DevManyPB/Control-2/presentaciones/pecha_kucha/img/bioreactor.jpg

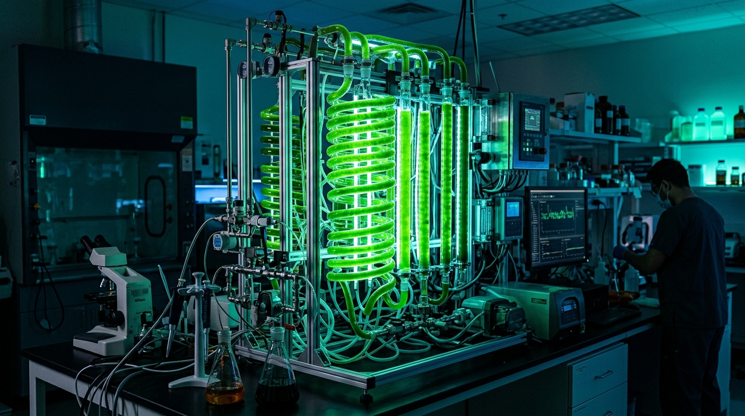
presentaciones/pecha_kucha/img/bioreactor.jpg
