DevManyPB/Control-2/presentaciones/pecha_kucha/img/frailejon.jpg

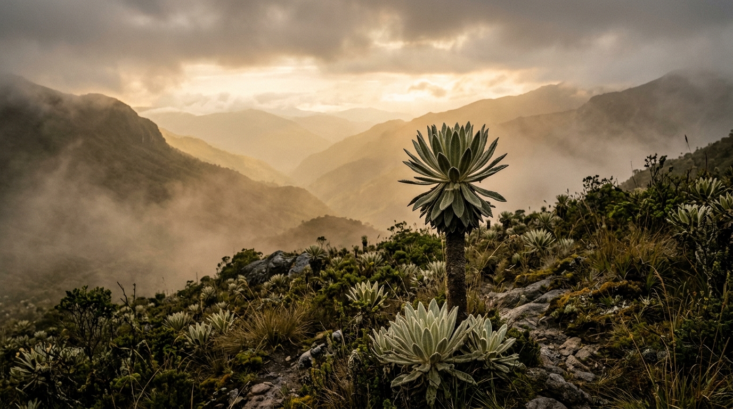
presentaciones/pecha_kucha/img/frailejon.jpg
