DevManyPB/Control-2/presentaciones/pecha_kucha/img/hardware.jpg

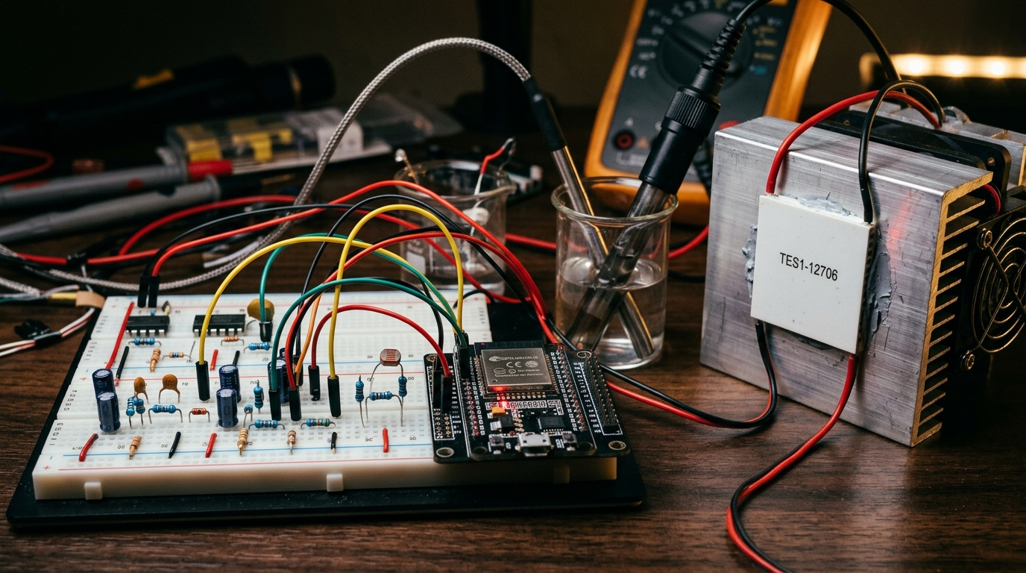
presentaciones/pecha_kucha/img/hardware.jpg
