DevManyPB/Control-2/presentaciones/pecha_kucha/img/microalgae.jpg

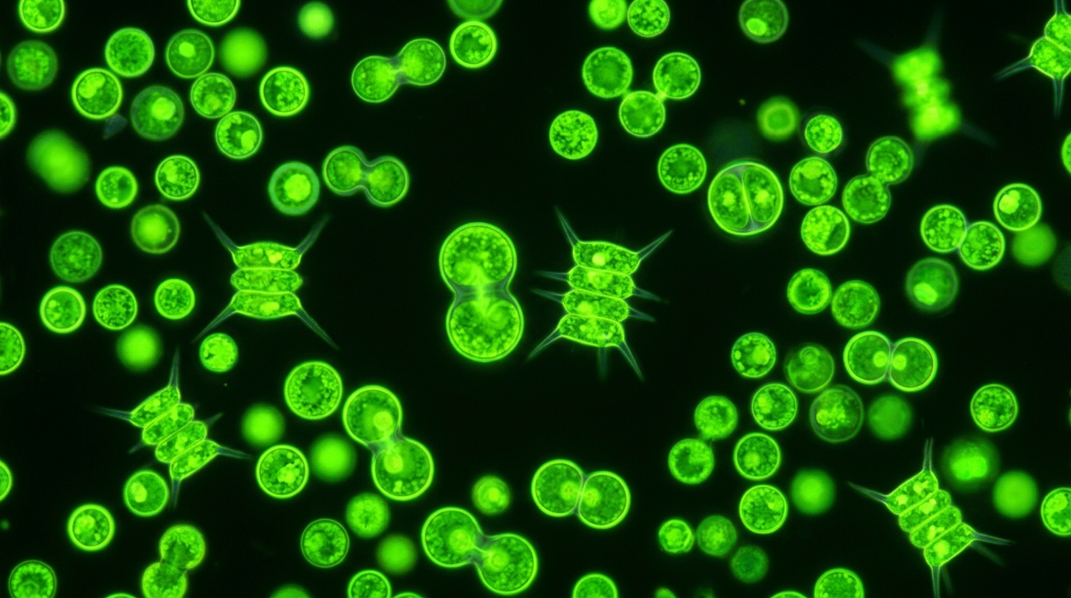
presentaciones/pecha_kucha/img/microalgae.jpg
