DevManyPB/Control-2/presentaciones/pecha_kucha/img/plot_ctmi.png

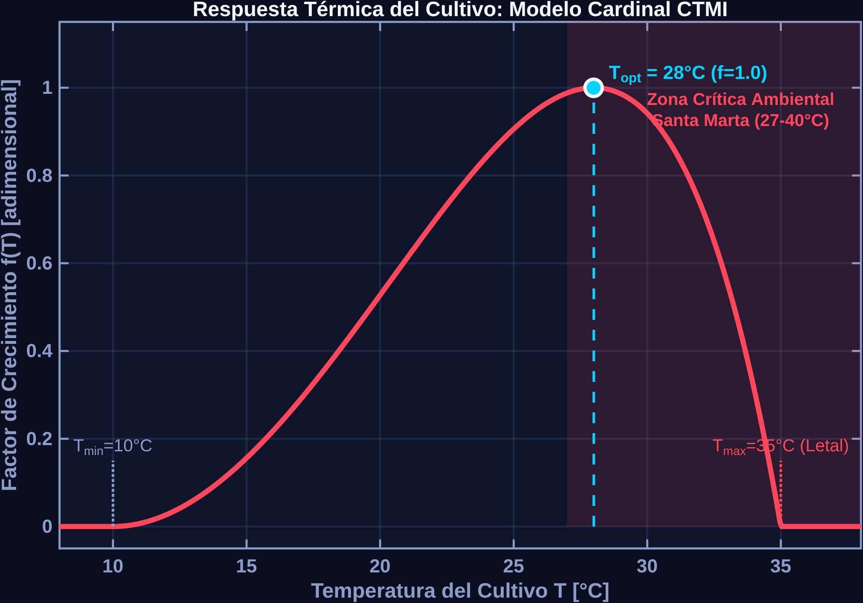
presentaciones/pecha_kucha/img/plot_ctmi.png
