DevManyPB/Control-2/presentaciones/pecha_kucha/img/plot_filter_i.png

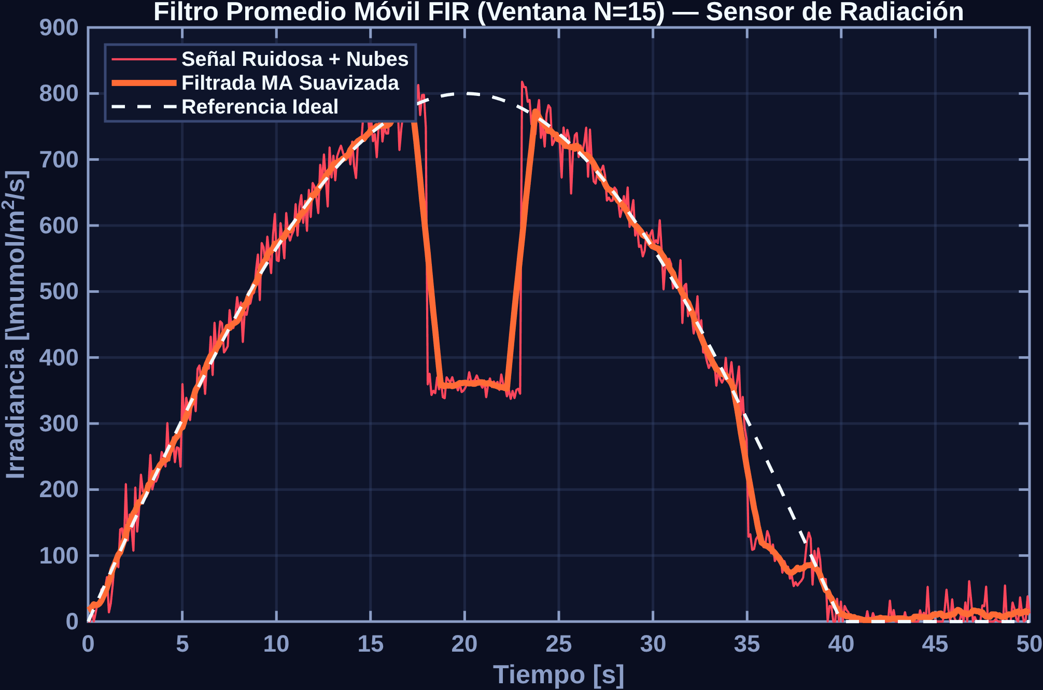
presentaciones/pecha_kucha/img/plot_filter_i.png
