DevManyPB/Control-2/presentaciones/pecha_kucha/img/plot_filter_ph.png

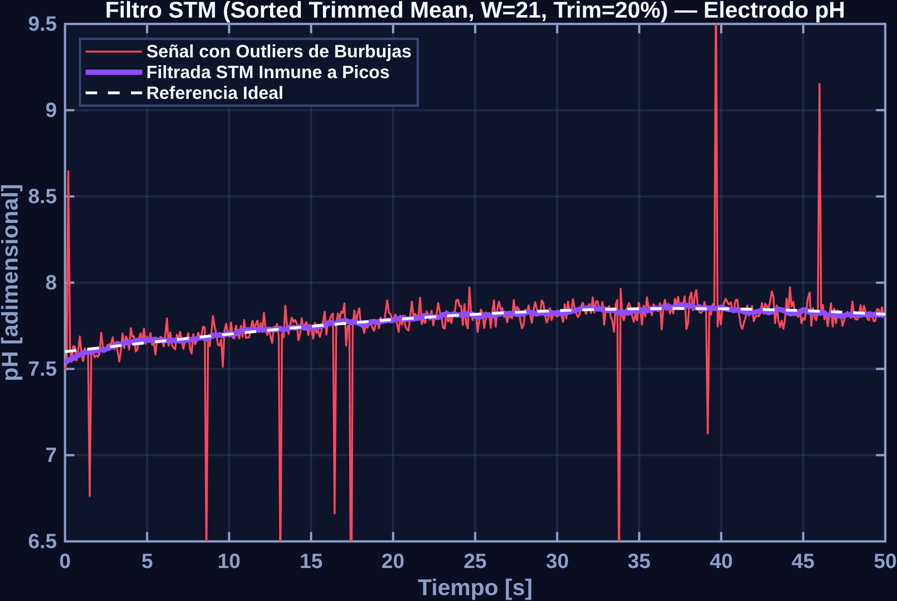
presentaciones/pecha_kucha/img/plot_filter_ph.png
