DevManyPB/Control-2/presentaciones/pecha_kucha/img/plot_filter_t.png

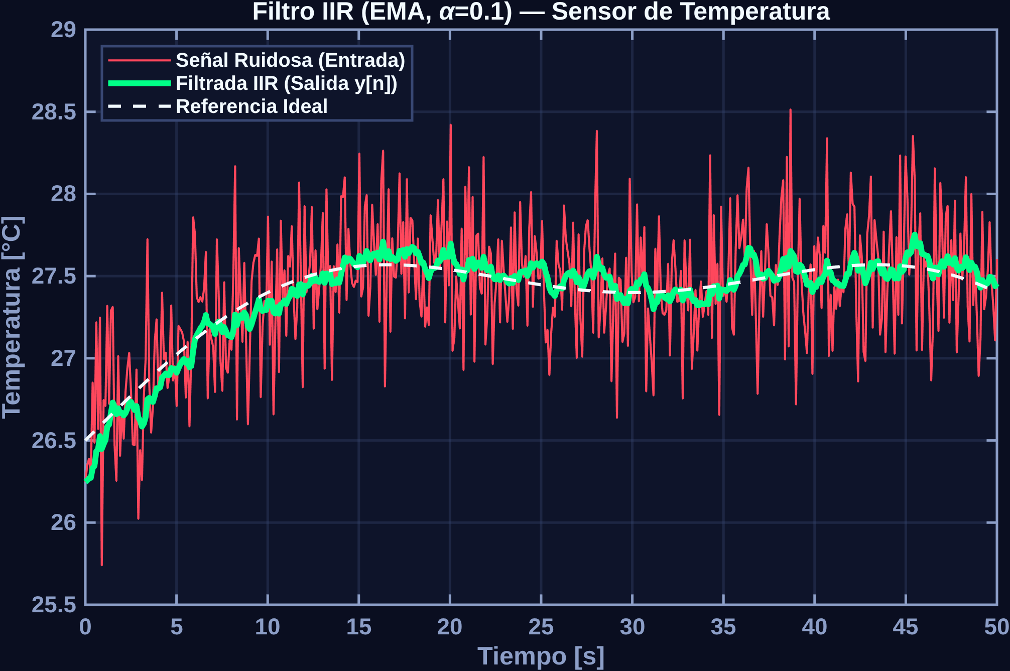
presentaciones/pecha_kucha/img/plot_filter_t.png
