DevManyPB/Control-2/presentaciones/pecha_kucha/img/plot_noise_i.png

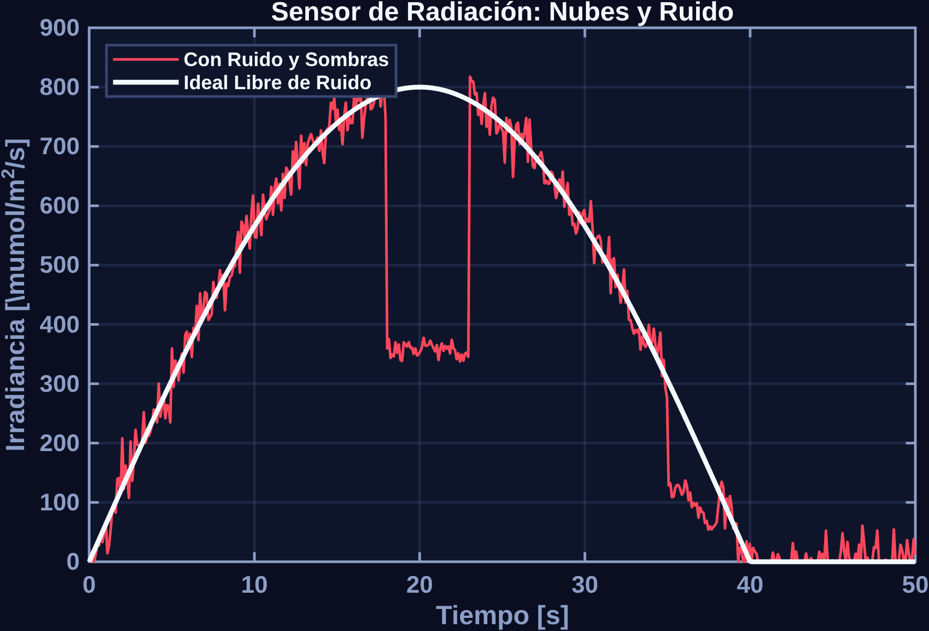
presentaciones/pecha_kucha/img/plot_noise_i.png
