DevManyPB/Control-2/presentaciones/pecha_kucha/img/plot_noise_ph.png

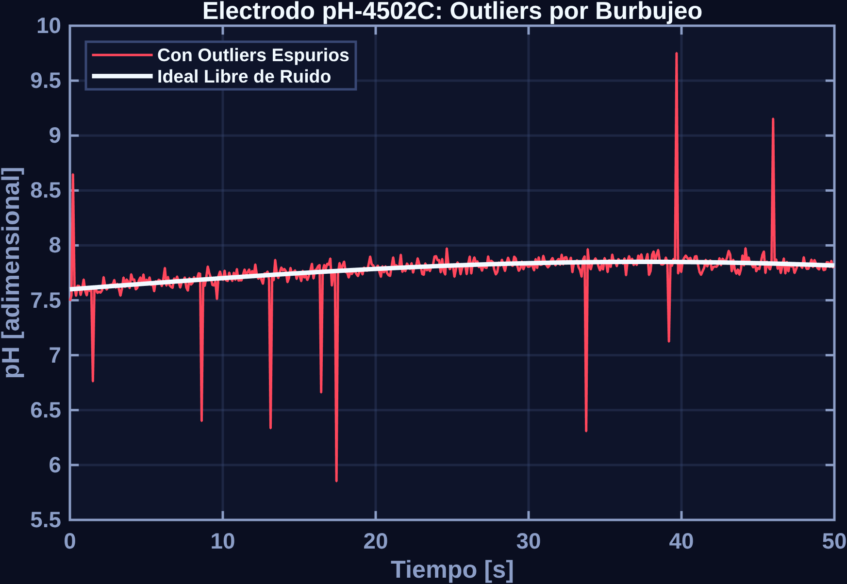
presentaciones/pecha_kucha/img/plot_noise_ph.png
