DevManyPB/Control-2/presentaciones/pecha_kucha/img/plot_sim_biomasa.png

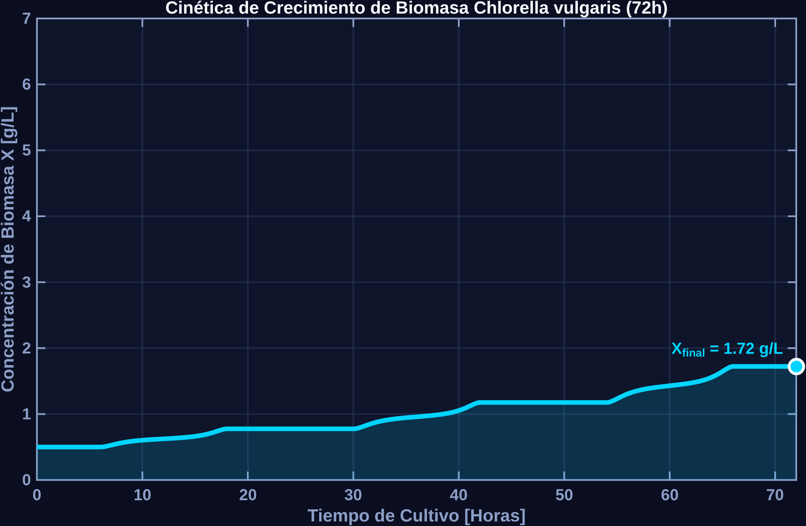
presentaciones/pecha_kucha/img/plot_sim_biomasa.png
