DevManyPB/Control-2/presentaciones/pecha_kucha/img/plot_steele.png

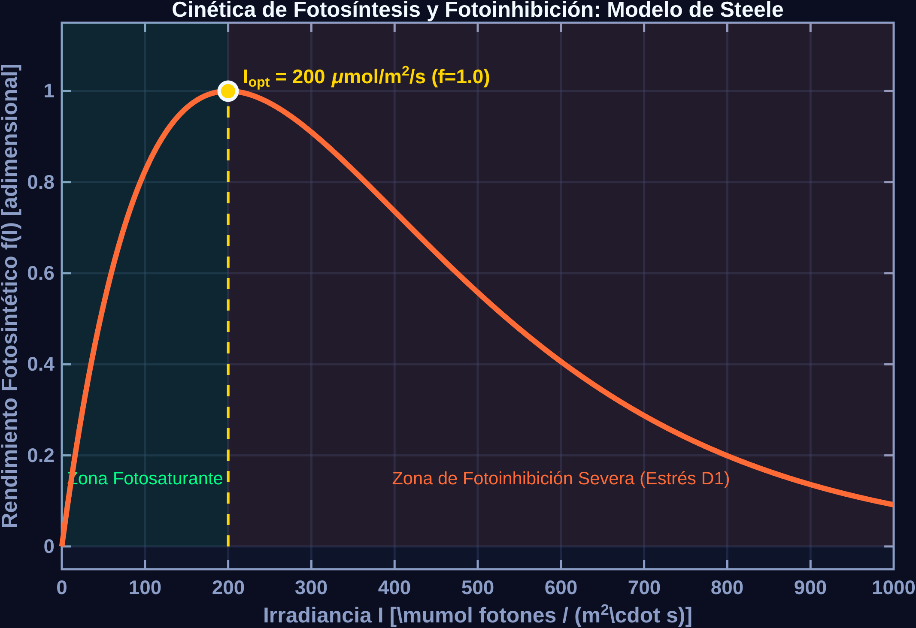
presentaciones/pecha_kucha/img/plot_steele.png
