DevManyPB/Control-2/presentaciones/pecha_kucha/img/signals.jpg

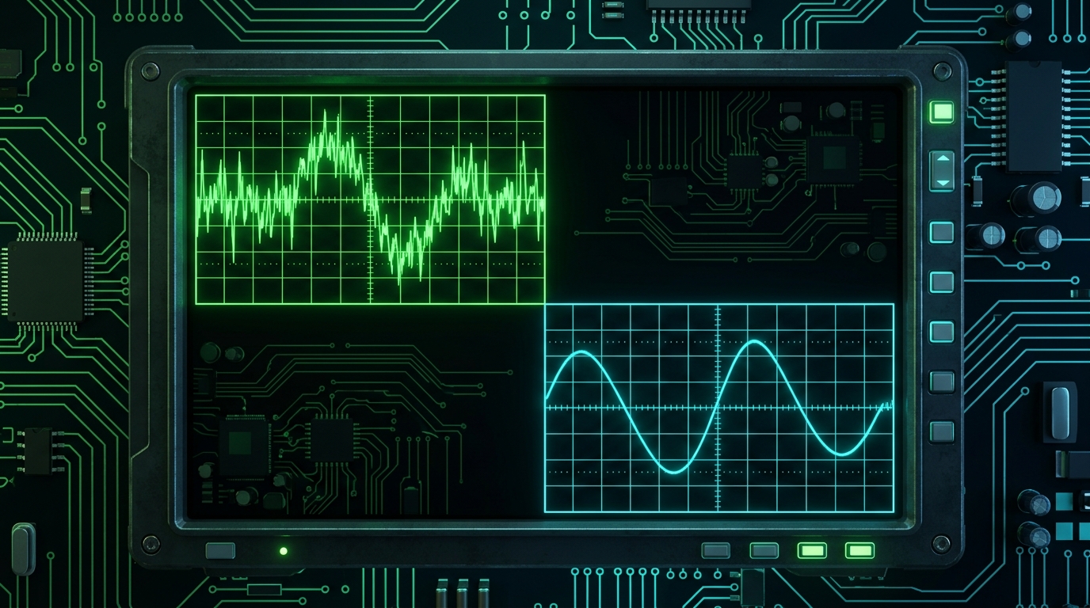
presentaciones/pecha_kucha/img/signals.jpg
