DevManyPB/Control-2/presentaciones/pecha_kucha/img/thermal.jpg

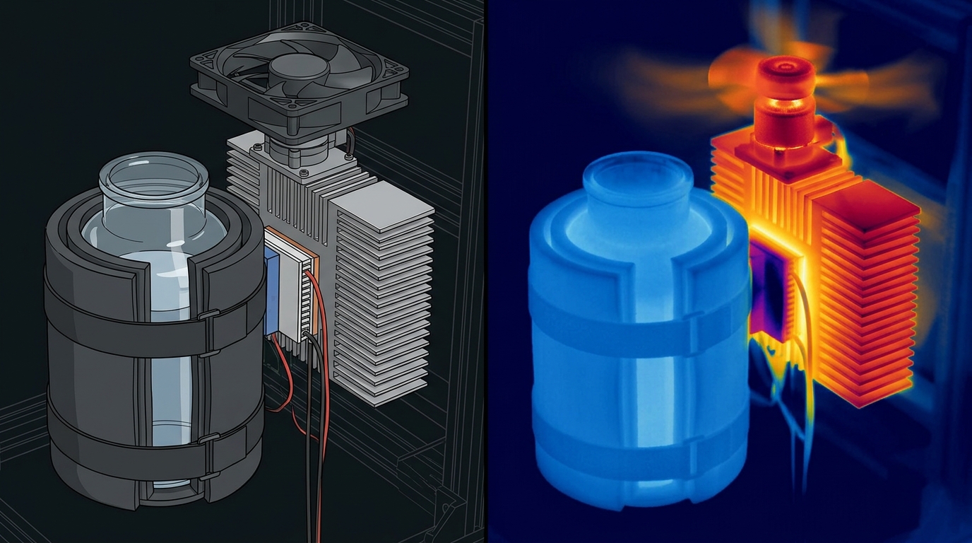
presentaciones/pecha_kucha/img/thermal.jpg
