DevManyPB/Control-2/presentaciones/presentacion_aluna/bioreactor_cartoon_1786323446804.png

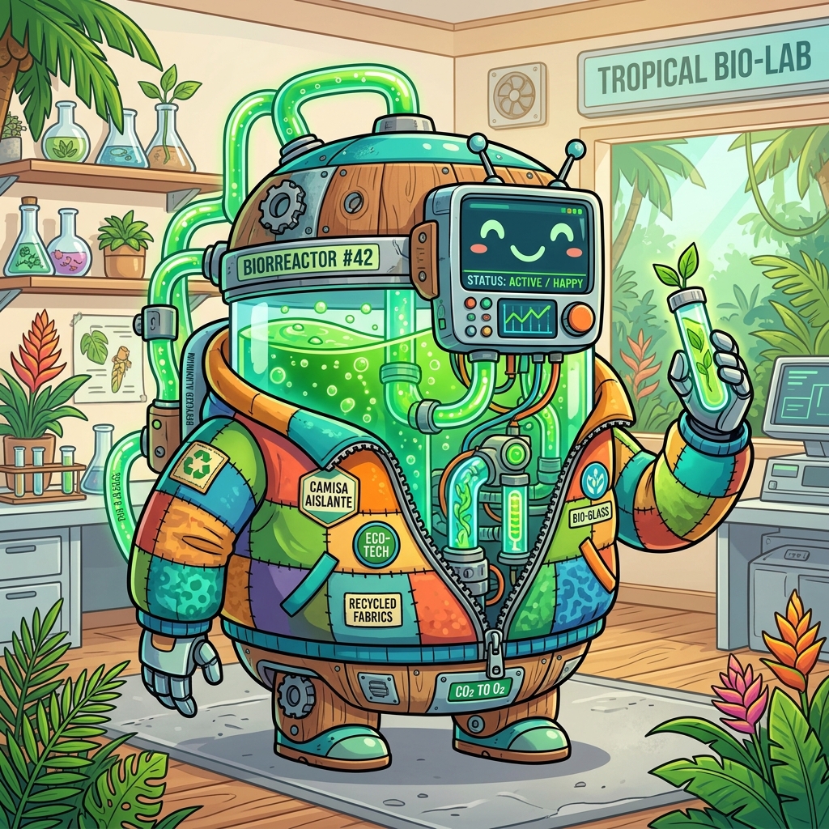
presentaciones/presentacion_aluna/bioreactor_cartoon_1786323446804.png
