DevManyPB/Control-2/presentaciones/presentacion_aluna/chlorella_character_1786323439290.png

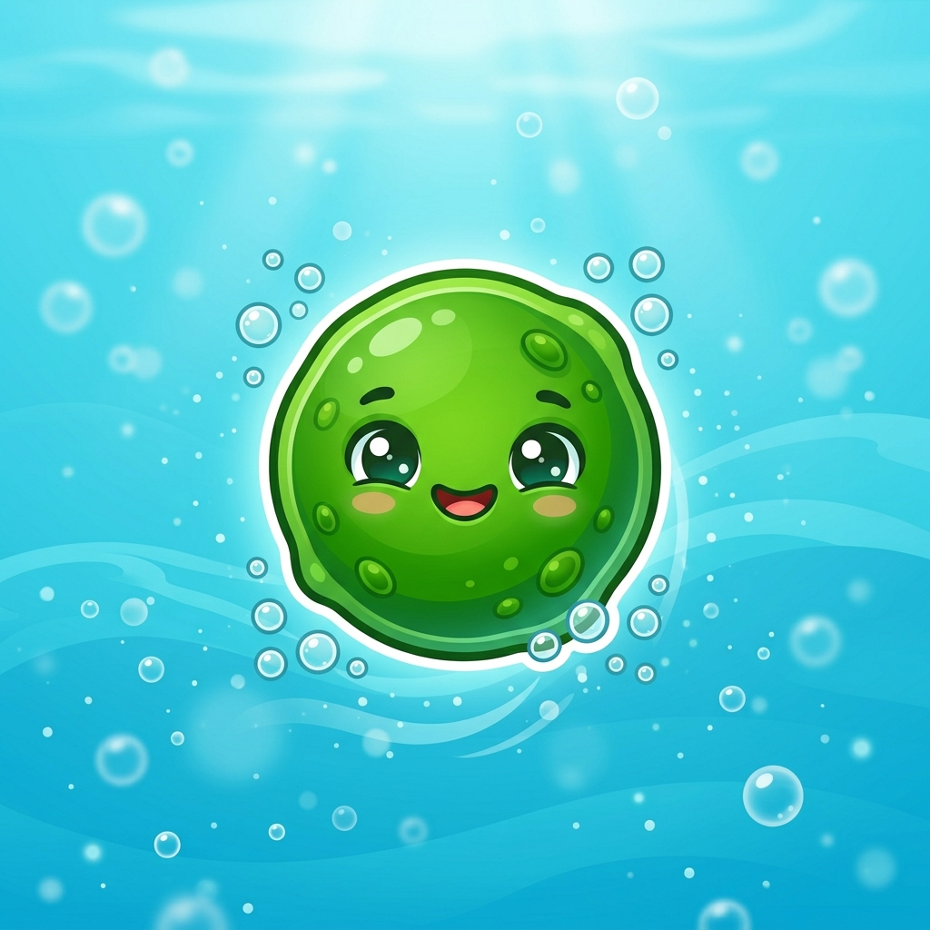
presentaciones/presentacion_aluna/chlorella_character_1786323439290.png
