DevManyPB/Control-2/presentaciones/presentacion_aluna/chlorella_vulgaris.png

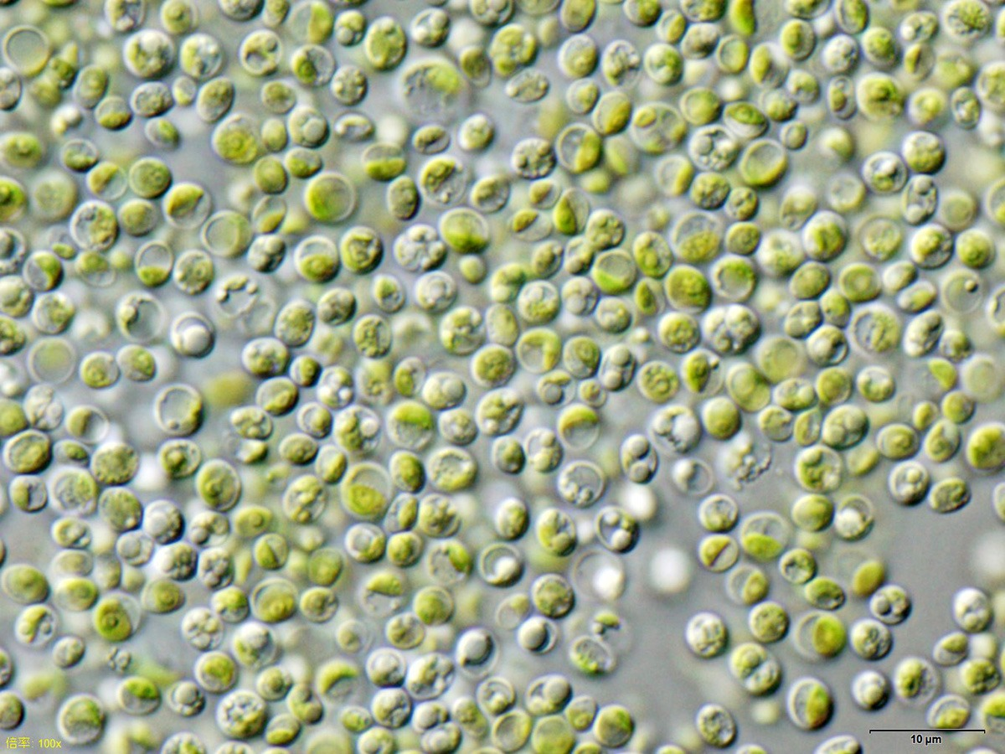
presentaciones/presentacion_aluna/chlorella_vulgaris.png
