DevManyPB/Control-2/presentaciones/presentacion_aluna/frailejon_character_1786323422099.png

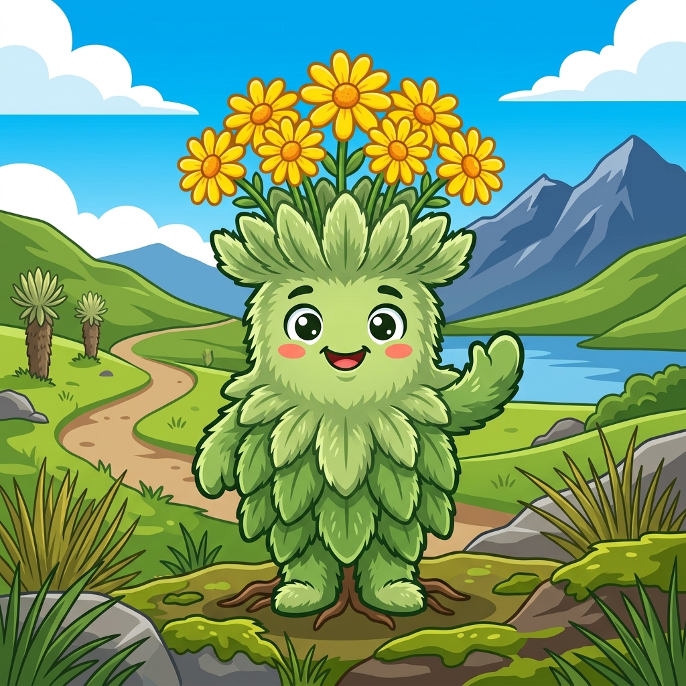
presentaciones/presentacion_aluna/frailejon_character_1786323422099.png
