DevManyPB/Control-2/presentaciones/presentacion_aluna/media__1786319531337.png

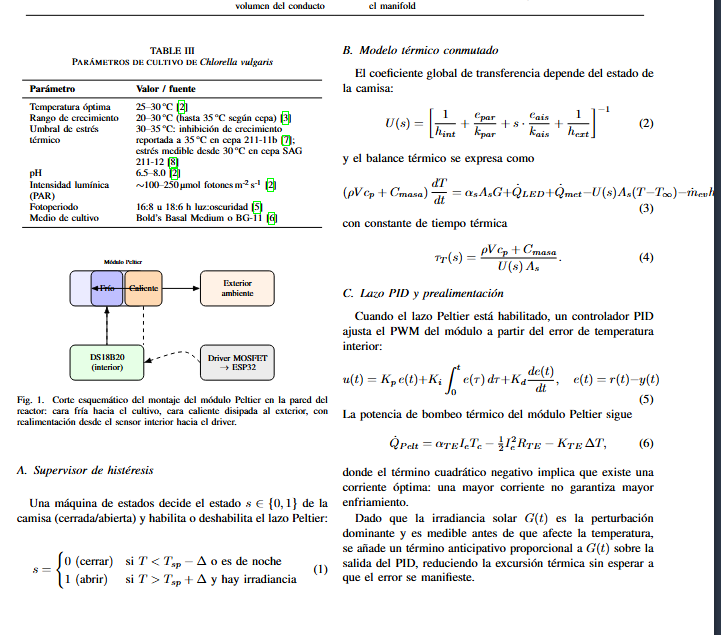
presentaciones/presentacion_aluna/media__1786319531337.png
