DevManyPB/Control-2/presentaciones/presentacion_aluna/media__1786319538570.png

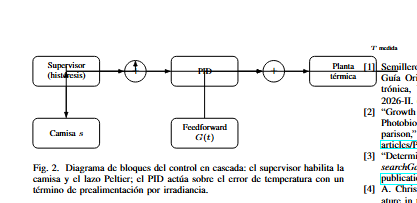
presentaciones/presentacion_aluna/media__1786319538570.png
