DevManyPB/Control-2/presentaciones/presentacion_aluna/media__1786319621300.png

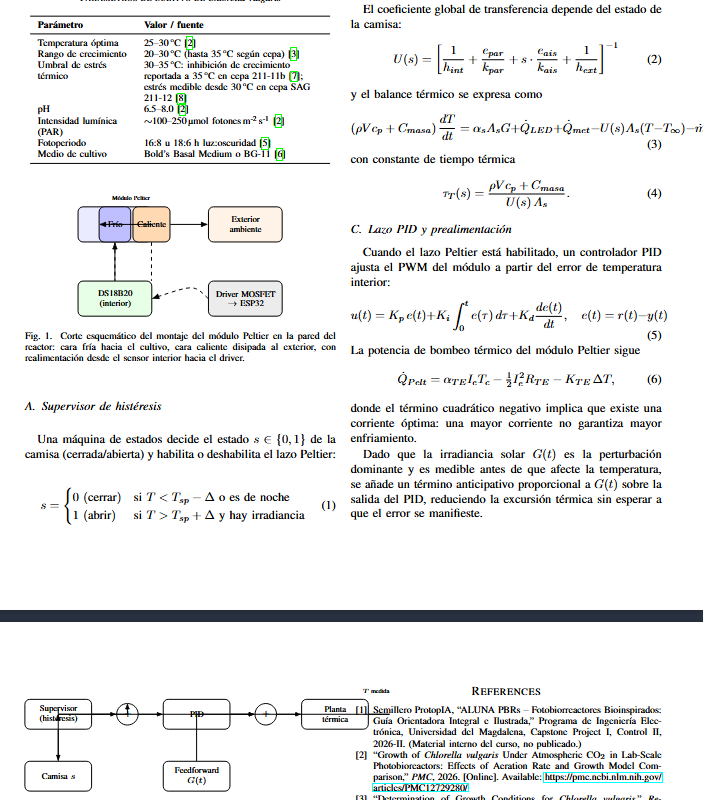
presentaciones/presentacion_aluna/media__1786319621300.png
