DevManyPB/Control-2/presentaciones/presentacion_aluna/media__1786319797948.png

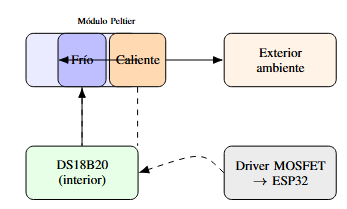
presentaciones/presentacion_aluna/media__1786319797948.png
