DevManyPB/Control-2/presentaciones/presentacion_aluna/media__1786319804138.png

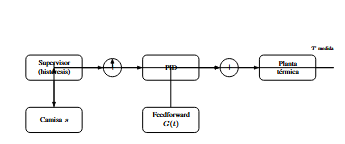
presentaciones/presentacion_aluna/media__1786319804138.png
