DevManyPB/Control-2/presentaciones/presentacion_aluna/media__1786319825323.png

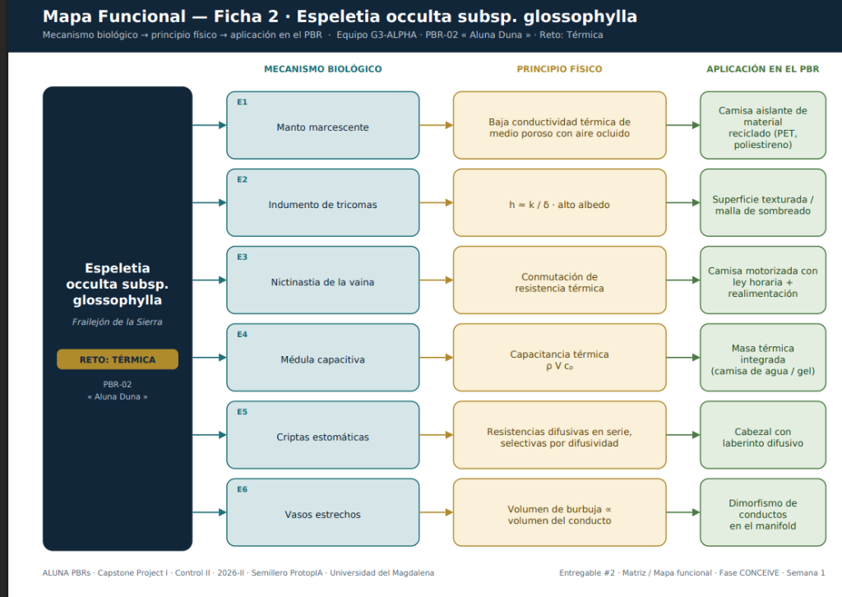
presentaciones/presentacion_aluna/media__1786319825323.png
