DevManyPB/Control-2/presentaciones/presentacion_aluna/ModeloFisico.jpeg

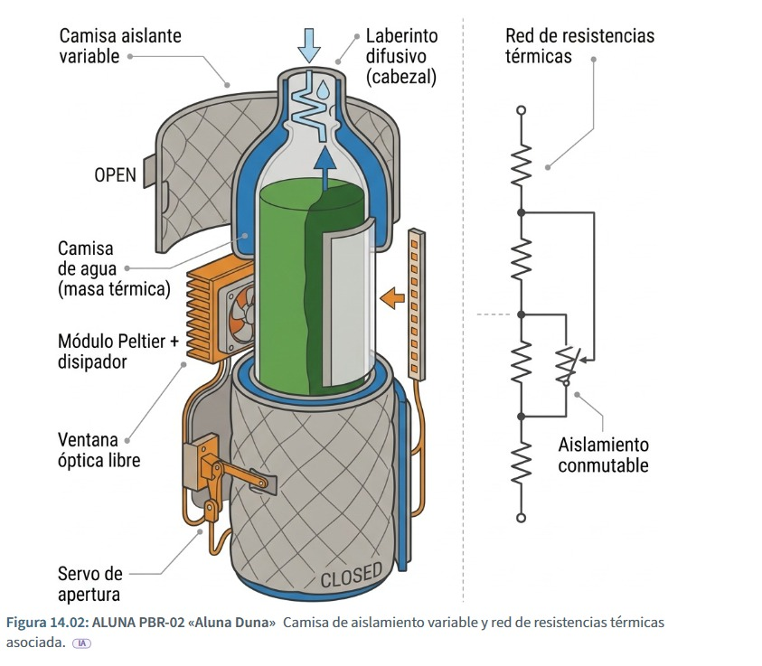
presentaciones/presentacion_aluna/ModeloFisico.jpeg
