DevManyPB/Control-2/presentaciones/presentacion_aluna/sierra_nevada_bg_1786323414918.png

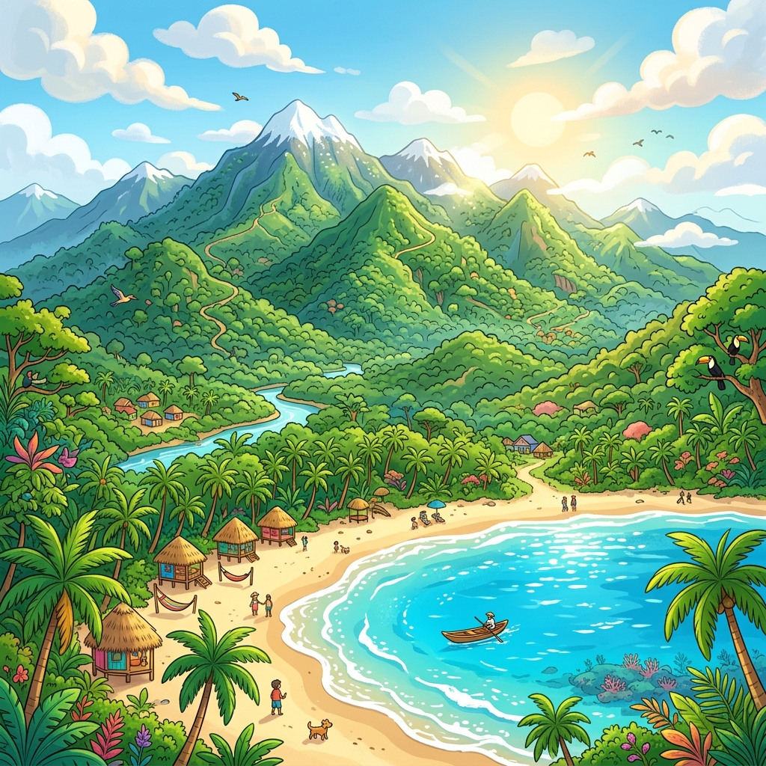
presentaciones/presentacion_aluna/sierra_nevada_bg_1786323414918.png
