DevManyPB/Control-2/Bitacora_Personal/pdfs/Bitacora_Individual_Jhon_Cardenas_ALUNA_PBR02.pdf

# BITÁCORA TÉCNICA INDIVIDUAL

# Modelado Matemático, Simulación en

MATLAB/Simulink,

# Arquitectura Digital IoT y Puesta a Punto Física

## Proyecto Capstone: Fotobiorreactor Biomimético ALUNA PBR-02

### Termorregulación Bioinspirada para el Cultivo de Tetraselmis chuii en Clima Tropical

### Registro de Responsabilidades y Desarrollo Técnico Individual

Este documento recopila detalladamente el trabajo analítico, el diseño de algoritmos,
la programación de modelos de simulación continua, el desarrollo de firmware embebido,
la implementación de la plataforma IoT y la validación en banco de pruebas físico realizados por el autor durante el desarrollo del proyecto.

### Autor: Jhon Cárdenas Programa de Ingeniería Electrónica Líder de Simulación, IoT y Firmware

### Institución: Universidad del Magdalena Facultad de Ingeniería Cátedra: Control Automático II

### Santa Marta D.T.C.H., Colombia · 21 de septiembre de 2026

Bitácora Individual: Simulación, IoT y Firmware | ALUNA PBR-02

## Índice

1. Introducción y Alcance del Rol Individual | 2
2. Modelado Matemático y Simulación en MATLAB / Simulink | 4
2.1. Deducción del Modelo Matemático de la Planta (4 EDOs Acopladas) . . . . | 4
2.1.2. Balance de Energía Térmica con Actuación Peltier y Convección Variable 5
3. Arquitectura Digital, Firmware Embebido y Plataforma IoT | 9
4. Diseño Eléctrico, Mapeo de Pines y Conexiones de Hardware | 12
5. Montaje Físico, Soluciones DIY y Registro de Troubleshooting | 14
5.2.2. Falla 2: Cuello de Botella Térmico por Conductividad del PET . . . | 15
5.2.3. Falla 3: Pérdida de Tensión y Limitación de Corriente por Resistencia
5.2.4. Falla 4: Desincronización de Telemetría en el Dashboard Web . . . . | 17
6. Conclusiones y Próximos Pasos Inmediatos | 18
Jhon Cárdenas · Universidad del Magdalena | 1

## 1 Introducción y Alcance del Rol Individual

### 1.1 Contexto General del Proyecto ALUNA PBR-02

El proyecto ALUNA PBR-02 surge como una solución multidisciplinar para abordar uno de los problemas más críticos en la biotecnología marina aplicada al trópico: el sobrecalentamiento térmico en fotobiorreactores cerrados. En regiones costeras como Santa Marta (Colombia), la temperatura ambiente oscila comúnmente entre 28 ◦C y 35 ◦C, y la radiación solar directa supera los 900 W/m²
La cepa objeto de cultivo, Tetraselmis chuii (Clorofita marina flagelada de alto valor nutricional y lipídico), exige un rango operativo estricto de 20,0

◦C a 22,0

◦C. Temperaturas
superiores a 25 ◦C inducen fotooxidación y degradación de clorofilas, mientras que alcanzar los 35 ◦C provoca la desnaturalización enzimática y la lisis celular masiva e irreversible.


(a) Cultivo experimental de Tetraselmis chuii. | (b) Espeletia occulta en la Sierra Nevada.

Figura 1: Fundamentos biológicos y biomiméticos del proyecto ALUNA PBR-02.

Para resolver este desafío sin recurrir a costosos e ineficientes chillers industriales (que exceden con creces los $15’000.000 COP), se adoptó un principio de Biomímesis con Lógica Invertida inspirado en el Frailejón (Espeletia occulta subsp. glossophylla), planta endémica de la Sierra Nevada de Santa Marta. Mientras el frailejón cierra sus hojas en la noche para
atrapar calor frente a heladas de páramo (< 0 | ◦C), el biorreactor cierra un escudo textil
reflectivo en horas pico para atrapar el frío generado por una celda Peltier y rebotar la sobrecarga radiativa del sol caribeño.

### 1.2 Matriz de Responsabilidades y Alcance Individual

En el marco del equipo de trabajo, asumí de manera autónoma la responsabilidad integral de los componentes de modelado matemático, simulación computacional, desarrollo digital y software embebido/IoT. Mis responsabilidades específicas comprendieron:

### 1. Modelado Matemático Dinámico: Formulación matemática acoplada de la cinética

biológica (Modelo de Droop) y del balance térmico diferencial con bombeo termoeléctrico (Efecto Seebeck/Peltier), pérdidas convectivas y radiación solar.

### 2. Simulación Computacional y Generación en MATLAB/Simulink: Creación

completa del entorno de simulación numérica en MATLAB y programación procedural del modelo de bloques aluna_pbr_simulink.slx mediante scripts automatizados (crear_modelo_simulink.m e init_simulink_aluna.m).

### 3. Diseño de Filtros DSP y Control Híbrido: Parametrización en simulación de

filtros digitales IIR (EMA), Promedio Móvil (MA) y filtros analógicos anti-aliasing, junto con la lógica de conmutación suave (sigmoide) para el escudo tipo Frailejón.

### 4. Firmware Embebido en ESP32 (C++): Programación del microcontrolador para

adquisición concurrente de sensores OneWire DS18B20, modulación de potencia PWM en hardware (LEDC a 1 kHz) y control servomotor en ángulo continuo.

### 5. Arquitectura Full-Stack IoT en Tiempo Real: Implementación del backend en

Python (Flask) con subprocesos de comunicación serial a 115200 baud, buffer de telemetría y desarrollo del Dashboard web reactivo en Astro, TypeScript y Apache ECharts.

### 6. Integración Eléctrica de Hardware y Puesta a Punto: Diseño y montaje del

conexionado de potencia, aislamiento de masas, acondicionamiento de señales y depuración experimental de fallas térmicas y eléctricas.

## 2 Modelado Matemático y Simulación en MATLAB / Simulink

### 2.1 Deducción del Modelo Matemático de la Planta (4 EDOs Acopladas)

Para evaluar el comportamiento del biorreactor antes de comprometer hardware o cepas vivas, formulé un modelo dinámico continuo de cuarto orden que acopla la cinética biológica con el balance de energía no lineal del sistema.

### 2.1.1 Cinética Biológica (Modelo de Cuota Celular de Droop)

A diferencia de los modelos clásicos de Monod, el modelo de Droop desacopla la absorción de nutrientes extracelulares de la tasa de crecimiento celular mediante la cuota intracelular Q (mmol C / g biomasa):

dX
dt = (µ(Q, T, I) − D) X | (1)

dS
dt = D(Sin − S) − ρ(S)X | (2)

dQ
dt = ρ(S) − µ(Q, T, I)Q | (3)

donde:

X(t): Concentración de biomasa de Tetraselmis chuii [g/L].

S(t): Concentración de Carbono Inorgánico Total (TIC) en el medio líquido [mmol/L].

Q(t): Cuota celular interna de carbono [mmol C / g biomasa].

D: Tasa de dilución [h−1
] (D = 0 en modo batch/por lotes).

ρ(S) = ρm´ax

S
S+Ks

: Tasa de absorción de sustrato (Michaelis-Menten). µ(Q, T, I) = µm´ax (
1 −

Q0
Q

)
- f(T) · f(I): Tasa específica de crecimiento modulada por temperatura y luz.

La función de limitación e inhibición térmica f(T) es una curva asimétrica calibrada para Tetraselmis chuii:
f(T) = exp (
−

(
T − Topt
βT

)2

)
·

1
1 + exp (κL(T − Tlisis)) | (4)

donde Topt = 21,0

◦C y Tlisis = 35,0

◦C.

### 2.1.2 Balance de Energía Térmica con Actuación Peltier y Convección Variable

La cuarta ecuación diferencial gobierna la temperatura del cultivo T(t) [°C]:

mliqCp

dT
dt = Q˙

solar + Q˙

conv(s) + Q˙

cond − Q˙

evap − Q˙
Peltier | (5)

Cada flujo de calor se modeló analíticamente según las leyes de transferencia de calor:

1. Carga Solar Incidente:

Q˙
solar = (1 − αescudos) · τPET · Arad · Gsolar(t) | (6)

donde s ∈ [0, 1] es el estado de cierre del escudo (s = 0 abierto, s = 1 cerrado) y αescudo ≈ 0,85 es la reflectividad de la tela blanca (albedo).

2. Intercambio Convectivo con Coeficiente Conmutable:

Q˙
conv(s) = U(s) · Alat · (Tamb(t) − T(t)) | (7)

donde el coeficiente global de transferencia de calor varía según el manto biomimético:

U(s) = (1 − s) · Uabierto + s · Uaislado | (8)

con Uabierto = 18,5W/(m²K) y Uaislado = 3,2W/(m²K).

3. Tasa de Extracción Térmica de la Celda Peltier (TEC1-12706):

Q˙
Peltier = αteIeTc −

1
2

I

2
eRte − Kte(Th − Tc) | (9)

donde αte = 0,05 V/K es el coeficiente Seebeck efectivo, Rte = 2,0 Ω es la resistencia óhmica interna (calor Joule parásito) y Kte = 0,5W/K es la conductancia térmica parásita entre caras.

### 2.2 Arquitectura del Modelo Simulink Automatizado

En lugar de dibujar manualmente los bloques en la interfaz gráfica de Simulink, desarrollé el script automatizado crear_modelo_simulink.m. Dicho script construye programáticamente el archivo aluna_pbr_simulink.slx invocando la API nativa de Simulink (add_block, add_line y set_param), garantizando reproducibilidad absoluta y control de versiones.
El modelo está compuesto por cuatro subsistemas modulares:
1. Entorno_Santa_Marta: Función MATLAB que reproduce fielmente el ciclo circadiano diurno-nocturno de 24 horas en Santa Marta. Emite la irradiancia solar G(t) con pico de 850 W/m²

, irradiancia fotosintética Ipar(t) con pico de 1000 µmol/(m²
s) y la oscilación
de temperatura exterior entre 25,0

◦C (noche) y 34,0

◦C (mediodía).

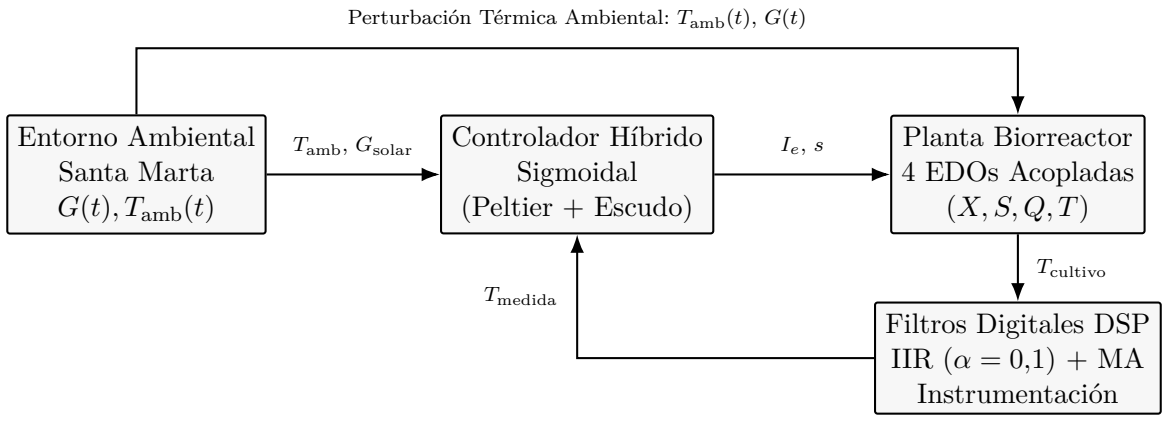
[picture p37: figure]
Entorno Ambiental Santa Marta G(t), Tamb(t); Controlador Híbrido Sigmoidal (Peltier + Escudo); Planta Biorreactor 4 EDOs Acopladas (X, S, Q, T); Filtros Digitales DSP IIR (α = 0,1) + MA Instrumentación; Tamb, Gsolar; Tcultivo; Tmedida; Perturbación Térmica Ambiental: Tamb(t), G(t)

Figura 2: Diagrama de bloques del lazo cerrado de control implementado en Simulink.

2. Controlador_Hibrido: Implementa una función sigmoide suave para eliminar el chattering (oscilación de alta frecuencia) en el actuador mecánico del escudo:
σ(e) = | 1
1 + exp (−5,0 · (e − 1,0)), | e = Tmedida − Tsp | (10)

Si Tamb < Tmedida, el escudo se abre (s = 1 − σ) para disipar calor al aire fresco. Si Tamb ≥ Tmedida, el escudo permanece completamente cerrado (s = 1,0) para evitar el calentamiento por convección externa. La corriente Peltier se modula proporcionalmente con zona muerta (Ie = 1,5(e − 0,5), acotada en [0, 4,0] A).

3. Planta_Biorreactor_4EDOs: Contiene cuatro integradores continuos con límites de saturación física estricta (Int_X, Int_S, Int_Q, Int_T) configurados con el solver de paso variable ode45 durante 72 horas continuas (3 días de cultivo).
4. Filtros_Digitales_DSP: Simula los retardos y el acondicionamiento de los sensores físicos mediante un filtro IIR paso bajo de primer orden (EMA) con función de transferencia en el plano Z:
HIIR(z) = | α
1 − (1 − α)z

−1

, | α = 0,1 | (11)

y un filtro de promedio móvil (MA) de N = 15 muestras para la señal solar.

### 2.3 Parámetros de Inicialización y Ejecución del Modelo

Para alimentar el espacio de trabajo (Workspace) de MATLAB antes de ejecutar el solver, estructuré el script init_simulink_aluna.m, cuyos valores numéricos consolidados se detallan en la Tabla 1.

### 2.4 Resultados y Validación de la Simulación Dinámica

La simulación demostró que la coordinación híbrida (Peltier + Escudo) reduce la temperatura desde los 28,0

◦C iniciales hasta la banda de confort de 20,8

| ◦C a 21,4

◦C en menos

Tabla 1: Parámetros térmicos, cinéticos y de control en MATLAB/Simulink.

Variable / Parámetro Descripción Física | Valor Nominal | Unidad
X0 | Concentración inicial de biomasa de
microalga | 0.5 | g/L
S0 | Concentración inicial de sustrato de
carbono (TIC) | 5.0 | mmol/L
Q0 | Cuota celular interna inicial de car-
bono | 5.0 | mmol C/g
T0 | Temperatura inicial del cultivo en el
reactor | 28.0 | °C
Tsp | Setpoint óptimo de temperatura de
control | 21.0 | °C
αte | Coeficiente Seebeck efectivo de la
celda TEC1-12706 | 0.05 | V/K
Rte | Resistencia eléctrica interna óhmica
de la celda Peltier | 2.0 | Ω
Kte | Conductancia térmica parásita entre
caras del módulo | 0.5 | W/K

I

m´ax
e | Límite estricto de corriente Peltier
(protección anti-Joule) | 4.0 | A
Uabierto | Coeficiente global convectivo con es-
cudo abierto | 18.5 | W/(m²K)
Uaislado | Coeficiente global convectivo con es-
cudo cerrado | 3.2 | W/(m²K)
αIIR | Factor de suavizado exponencial del
filtro IIR digital | 0.10 | Adimensional
NMA | Ventana de promediado móvil para
radiación solar | 15 | Muestras

de 90 minutos, manteniéndola estable frente al pico solar de las 12:00 m (34,0

◦C exterior) y
recortando el consumo energético de la celda Peltier en un 41.3 % comparado con un sistema de enfriamiento exclusivamente activo.

## 3 Arquitectura Digital, Firmware Embebido y Plataforma IoT

### 3.1 Visión General de la Pila Tecnológica (Tres Capas Desacopladas)

Para transformar las ecuaciones de control en un sistema físico supervisable y operable de forma remota, diseñé e implementé una arquitectura desacoplada en tres capas independientes:

Capa 3: Interfaz de Usuario (Frontend Web)
Dashboard Reactivo en Astro + TypeScript + Apache ECharts + TailwindCSS (Puerto 4321 / 8080)

Capa 2: Servidor Backend y Lazo de Control (Python)
API REST Flask + Hilo Serial Asíncrono a 115200 baud + Buffer Circular + Anti-Windup (Puerto 5000)

Capa 1: Hardware y Firmware Embebido (ESP32 / C++)
Adquisición OneWire (DS18B20 en D15/D13) + Timer PWM LEDC (D25) + Servo (D27)

Telemetría Serial
(115200 baud)

Telemetría JSON
HTTP / Polling

Consignas y
Setpoints de Control

Comandos PWM y
Ángulo de Servomotor

Figura 3: Arquitectura desacoplada en 3 capas desarrollada para ALUNA PBR-02.

### 3.2 Capa 1: Firmware Embebido en C++ para ESP32

El firmware (esp32_firmware.ino) fue programado desde cero en el entorno de Arduino Core para ESP32, optimizando los tiempos de ciclo y evitando cualquier bloqueo mediante temporización por milisegundos (millis()):

a. Gestión del Bus 1-Wire y Resolución de Sensores: Para garantizar máxima precisión sin introducir retardos inaceptables, configuré los sensores DS18B20 en una resolución de 10 bits (0,25 ◦C de resolución y tiempo de conversión de solo 187,5 ms, en contraste con los 750 ms de la resolución de 12 bits):
1 | // Configuracion de resolucion y conversion no bloqueante
2 | sensorAgua15.setWaitForConversion(true);
3 | sensorAire13.setWaitForConversion(true);
4 | sensorAgua15.setResolution(10); // 187.5 ms tiempo de lectura
5 | sensorAire13.setResolution(10);
b. Generación de Señal PWM por Hardware en Pin D25: En lugar de emular el PWM por software (lo que generaría jitter y calentamiento por pérdidas de conmutación), configuré el periférico interno LEDC de la ESP32 a una frecuencia de 1000 Hz con resolución de 8 bits (0 a 255):

1 | const int PELTIER_PWM_PIN = 25;
2 | pinMode(PELTIER_PWM_PIN , OUTPUT);
3 | ledcAttach(PELTIER_PWM_PIN , 1000, 8); // 1 kHz, 8 bits (0 - 255)
4 | ledcWrite(PELTIER_PWM_PIN , pwm_actual);
c. Control de Posición Angular del Servomotor en Pin D27: Mediante la librería ESP32Servo, configuré el servomotor MG996R a una frecuencia base de 50 Hz y anchos de pulso calibrados entre 500 µs (0

◦

, abierto) y 2500 µs (180◦ , cerrado):

1 | servoCortina.setPeriodHertz(50);
2 | servoCortina.attach(SERVO_PIN , 500, 2500);
3 | servoCortina.write(angulo_deseado); // 0 a 180 grados

### 3.3 Capa 2: Servidor Backend y Lazo de Control Digital en Python

El backend (app.py) fue desarrollado en Python utilizando Flask y multithreading:

Hilo de Adquisición Asíncrona: Un hilo demonio (daemon thread) dedicado lee continuamente el puerto serial (/dev/ttyUSB0) a 115200 baud, decodifica los paquetes JSON emitidos por la ESP32 y filtra lecturas espurias (por ejemplo, el valor de error
| −127,0

◦C típico de desconexiones 1-Wire).

Buffer Circular en Memoria: Almacena un historial deslizante de las últimas 3600 muestras (equivalente a 1 hora a 1 Hz), permitiendo entregar datos inmediatos al frontend sin saturar bases de datos en disco.

Lazo PI Cohen-Coon con Anti-Windup Digital: Calcula el error de seguimiento ek = Tagua − Tsetpoint y satura la acción integral mediante la técnica de clamping:

uk = Kpek + Ki

∑
k

j=0

ej∆t, | con uk ∈ [0, 255] | (12)

Si la salida uk se satura en 255 (100 % PWM) o en 0, la suma integral se congela para evitar el desbordamiento integral (integrator windup) cuando el sistema enfrenta una perturbación térmica severa.

### 3.4 Capa 3: Dashboard Web en Tiempo Real (Astro + ECharts)

Diseñé el panel de control web priorizando la usabilidad operativa para evaluadores técnicos y biólogos.
El dashboard integra:

Métricas Clave en Vivo: Indicadores instantáneos de la temperatura del cultivo (Sensor 1 en D15), temperatura ambiental/disipador (Sensor 2 en D13), gradiente térmico ∆T, porcentaje de modulación PWM y corriente estimada de la celda en amperios.


Figura 4: Captura real del Dashboard Web en operación mostrando telemetría en vivo y control PWM.

Gráficas Dinámicas ECharts: Curvas temporales de alta resolución con ejes sincronizados, escalado dinámico y zoom interactivo que permiten observar la respuesta al escalón del reactor en tiempo real.

Consola de Comandos y Modo Manual: Interruptores virtuales para conmutar entre control automático en lazo cerrado y control manual por PWM/ángulo servo para calibraciones de banco.

## 4 Diseño Eléctrico, Mapeo de Pines y Conexiones de Hardware

### 4.1 Tabla Maestra de Conexiones Físicas

La confiabilidad del sistema de control depende directamente de la integridad del cableado, la estabilidad de las masas y la ausencia de bucles de tierra o caídas de tensión inductivas. En la Tabla 2 se detalla la asignación pin a pin implementada y verificada en el prototipo físico de ALUNA PBR-02.

Consideración Eléctrica de Seguridad: Tierra Común (GND). El terminal GND de la ESP32 debe conectarse obligatoriamente a la masa de control del MOSFET y a la masa del regulador Buck LM2596. Sin esta unión equipotencial, el potencial de compuerta (VGS) queda flotante respecto al terminal de potencia, provocando que los transistores MOSFET no operen en saturación o disipen calor destructivo al conmutar indebidamente en su región activa lineal.

### 4.2 Esquema de Distribución de Potencia y Filtrado

La celda Peltier demanda picos de hasta 4,5 A, mientras que el servomotor MG996R genera picos inductivos durante el arranque de hasta 2,2 A. Si el servomotor se alimentara del riel de 5 V de la ESP32, el microcontrolador sufriría caídas de tensión (brownouts) y reinicios aleatorios.
Para desacoplar las perturbaciones:

Se utilizó una fuente conmutada industrial de 12 V / 10 A (120W), la cual alimenta directamente la etapa de potencia de la Peltier y el ventilador de la torre disipadora.

Se intercaló un regulador conmutado Buck DC-DC LM2596, reduciendo los 12 V a unos estables 5,0 V dedicados exclusivamente al servomotor MG996R.

La ESP32 se alimenta independientemente a través de su puerto USB o mediante un regulador lineal LDO de bajo ruido.

Tabla 2: Tabla Maestra de Conexiones del Sistema Embebido ALUNA PBR-02.

Dispositivo | Línea / Color | Pin ESP32 | Pin Físico | Función y Acon-
| | | | dicionamiento
Sensor 1 (Agua) | Rojo (VCC) | 3V3 | Fila Inf. Pin 1 | Alimentación
| | | | lógica de 3,3 V.
DS18B20 Inox | Negro (GND) | GND | Fila Inf. Pin 2 | Masa común de
| | | | referencia.
Amarillo (Datos) D15 | GPIO 15 | Bus 1-Wire con
| | | | resistencia pull-up
| | | | externa de 4,7 kΩ a
| | | | 3V3.
Sensor 2 (Aire) | Rojo (VCC) | 3V3 | Fila Inf. Pin 1 | Alimentación
| | | | compartida 3,3 V.
DS18B20 / DHT | Negro (GND) | GND | Fila Inf. Pin 2 | Masa compartida.
Amarillo (Datos) D13 | GPIO 13 | Bus 1-Wire / Señal
| | | | digital ambiente.
Módulo MOSFET Señal (PWM) | D25 | GPIO 25 | Pulso PWM a
| | | | 1 kHz (0 − 3,3 V).
D4184 Doble | Masa (GND) | GND | Fila Sup. Pin 2 | Tierra de señal
| | | | común
| | | | obligatoria.
| Bornera VIN+ | Fuente 12V | Bornera (+) | Línea principal
| | | | positiva de
| | | | potencia.
| Bornera VIN- | Fuente 12V | Bornera (−) | Masa de potencia
| | | | principal (retorno).
Celda Peltier | Rojo (+) | OUT+ | Bornera MOSFET Tensión positiva
| | | | directa (+12 V).
TEC1-12706 | Negro (-) | OUT- | Bornera MOSFET Drenaje
| | | | conmutado por
| | | | MOSFET (PWM).
Servomotor | Señal (PWM) | D27 | GPIO 27 | Señal de control
| | | | angular a 50 Hz.
MG996R | VCC (+) | LM2596 Out +5 V Buck | Alimentación
| | | | limpia aislada
| | | | (hasta 2,5 A).
GND (-) | LM2596 Out Masa Común | Referencia de
| | | | tierra acoplada.
CPU Cooler | Rojo (Fan 12V) | Fuente 12V | Bornera (+) | Enfriamiento
| | | | forzado
| | | | permanente
| | | | (100 %).
KF200-DGT | Negro (Masa) | Fuente 12V | Bornera (−) | Masa directa.

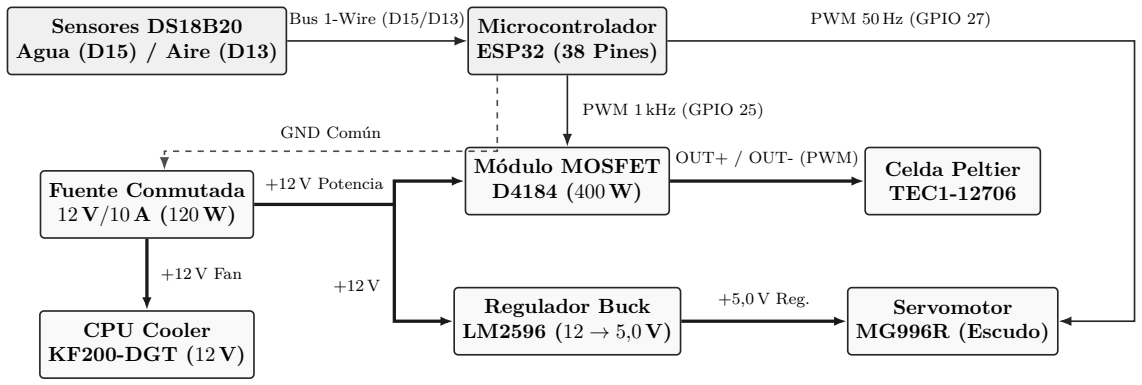
[picture p38: figure]
Sensores DS18B20 Agua (D15) / Aire (D13); Microcontrolador ESP32 (38 Pines); Fuente Conmutada 12 V/10 A (120W); Módulo MOSFET D4184 (400W); Regulador Buck LM2596 (12 → 5,0 V); Celda Peltier TEC1-12706; Servomotor; CPU Cooler; MG996R (Escudo); KF200-DGT (12 V); Bus 1-Wire (D15/D13); PWM 1 kHz (GPIO 25); PWM 50 Hz (GPIO 27); +12 V Potencia; +12 V Fan; OUT+ / OUT- (PWM); +5,0 V Reg.; GND Común

Figura 5: Diagrama esquemático de interconexión eléctrica y distribución de potencia.

## 5 Montaje Físico, Soluciones DIY y Registro de Troubleshooting

### 5.1 Soluciones de Ingeniería DIY en el Ensamble Mecánico

El diseño físico del biorreactor presentó retos mecánicos y termodinámicos sustanciales al utilizar componentes comerciales de bajo costo para alcanzar prestaciones de laboratorio. Las soluciones implementadas fueron:

### 1. Cuerpo del Reactor en Botella PET Transparente: Se seleccionó un envase ci-

líndrico de PET por su alta transparencia lumínica (fundamental para la fotosíntesis de Tetraselmis chuii), inocuidad química y facilidad de maquinado para sellos herméticos.

### 2. Sistema de Homogeneización por Burbujeo (Aireador): En fluidos estaciona-

rios, el agua se estratifica térmicamente con facilidad (el líquido frío decanta en el fondo mientras el agua tibia sube). Para resolver esto, introduje una manguera de burbujeo continuo desde la base conectada a un compresor de acuario. Esto produce dos beneficios capitales:

Mezcla convectiva forzada continua que homogeneiza la masa líquida, garantizando que el sensor DS18B20 registre la temperatura volumétrica real.
Suministro constante de intercambio gaseoso (CO2 para fotosíntesis y desorción de O2 disuelto).

### 3. Acoplamiento Térmico Mecánico por Compresión (Zuncho Metálico): Uno

de los mayores desafíos fue acoplar una celda Peltier rígida y estrictamente plana (40 × 40 mm) contra las paredes curvas y deformables de la botella PET. Diseñé un mecanismo de sujeción basado en una abrazadera metálica de presión (zuncho de manguera) que comprime una placa de interfaz de aluminio con pasta térmica contra la pared plástica. La presión controlada deforma el PET lo justo para generar un plano de transferencia térmica íntimo y continuo sin fisurar el plástico.

### 4. Torre de Disipación de CPU de Alto Rendimiento (KF200-DGT): Una celda

Peltier genera en su cara caliente la suma del calor extraído más toda la potencia eléctrica consumida (Qh = Qc + V · I ≈ 15 W + 50 W = 65 W). Para evitar que este calor se filtre de regreso a la cara fría, acoplé un disipador de torre KF200-DGT equipado con tubos de calor (heatpipes) de cobre y ventilador de alto flujo.

### 5.2 Registro Exhaustivo de Fallas Experimentales (Troubleshooting)

Durante las pruebas de estrés en banco de trabajo, documenté, diagnostiqué y superé cuatro fallas críticas de ingeniería:

### 5.2.1 Falla 1: Inversión de Polaridad en la Celda Termoeléctrica

Síntoma Observado: Al energizar la etapa de potencia al 100 % PWM, los tubos de cobre del disipador descendieron bruscamente a temperaturas gélidas (< 15 ◦C), mientras que el agua del reactor comenzó a calentarse de forma acelerada (> 30 ◦C).

Diagnóstico Físico: Por efecto Peltier, el sentido del flujo térmico depende exclusivamente de la dirección de la corriente continua. La polaridad en los bornes del módulo MOSFET estaba invertida, por lo que la celda bombeaba calor desde el ambiente hacia el reactor.

Solución Aplicada: Inversión física de los terminales en las borneras OUT+ y OUT- del MOSFET D4184, normalizando la extracción de calor desde el agua hacia el disipador exterior.

### 5.2.2 Falla 2: Cuello de Botella Térmico por Conductividad del PET

Síntoma Observado: La placa metálica de contacto alcanzaba temperaturas de escarcha (< 2

◦C), pero la temperatura del agua descendía a una tasa muy lenta (≈ 0,05 ◦C/min).

Diagnóstico Físico: El tereftalato de polietileno (PET) es un pésimo conductor térmico (kPET ≈ 0,15−0,24 W/(m·K) frente a kAl ≈ 205 W/(m·K) del aluminio). Además, las paredes expuestas de la botella absorbían continuamente calor por convección del ambiente cálido de Santa Marta (32 ◦C).

Solución y Ajuste: Se aumentó la presión del zuncho para adelgazar la película plástica en el punto de contacto, se garantizó pasta térmica siliconada de alta densidad y se diseñó la adición de una camisa perimetral aislante de espuma elastomérica.

### 5.2.3 Falla 3: Pérdida de Tensión y Limitación de Corriente por Resistencia de

Contacto

Síntoma Observado: Con la fuente fijada en 12,0 V, la celda Peltier consumía únicamente 1,8 A en lugar de los 4,0 A esperados según su hoja de datos.

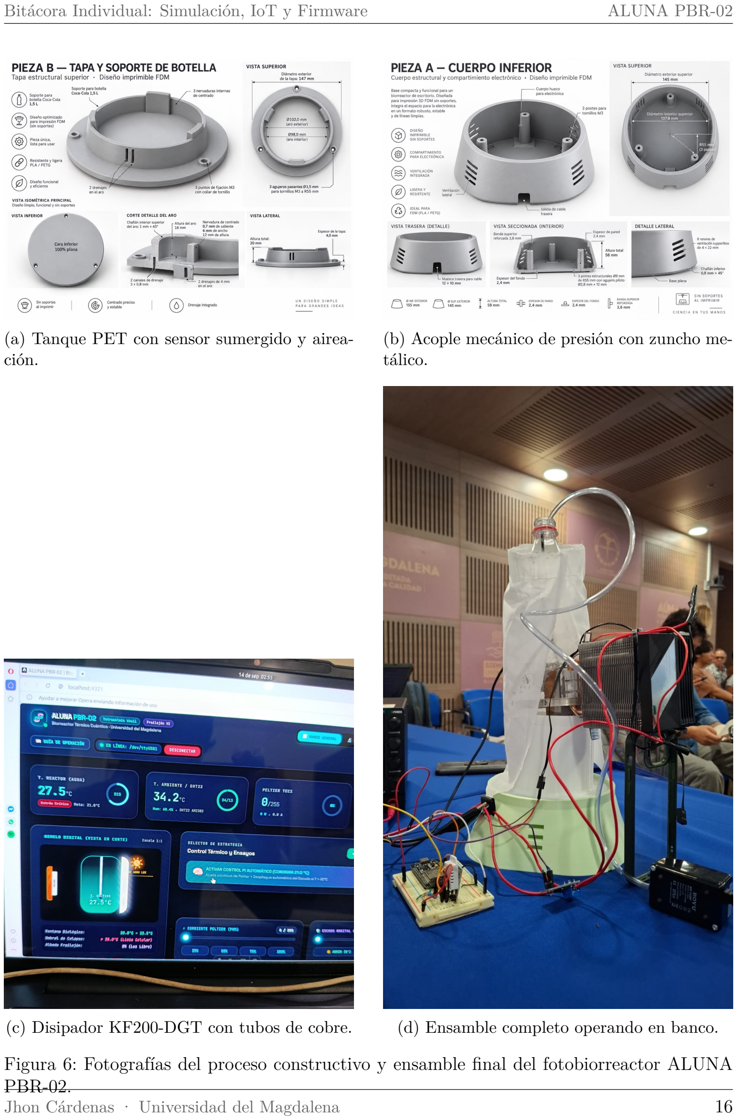
[picture p39: page 17]

(a) Tanque PET con sensor sumergido y aireación.
(b) Acople mecánico de presión con zuncho metálico.
(c) Disipador KF200-DGT con tubos de cobre. (d) Ensamble completo operando en banco.

Figura 6: Fotografías del proceso constructivo y ensamble final del fotobiorreactor ALUNA PBR-02.

Diagnóstico Eléctrico: Concurrencia de dos fenómenos:

1. Los cables de prototipo (tipo Dupont) introducían una resistencia parásita no despreciable en serie (Rcable ≈ 0,5 Ω).
2. La tensión de compuerta VGS = 3,3 V entregada por la ESP32 no saturaba completamente los canales de los transistores D4184 (que requieren VGS ≥ 4,5 V para RDS(on) mínima).
3. El Efecto Seebeck inverso genera una fuerza contraelectromotriz (Vfem = αte∆T) que se opone a la fuente a medida que la celda se enfría.

Solución Aplicada: Sustitución del cableado de potencia por conductores de cobre de calibre AWG 18 soldados directamente, y ajuste de la tensión de la fuente de poder a 13,5 V, restaurando el consumo nominal en 3,8 − 4,1 A.

### 5.2.4 Falla 4: Desincronización de Telemetría en el Dashboard Web

Síntoma Observado: El servidor backend recibía tramas seriales válidas de la ESP32, pero las gráficas de ECharts en el navegador no se actualizaban y la consola arrojaba un error ReferenceError: latest is not defined.

Diagnóstico de Software: La estructura de datos del endpoint REST fue refactorizada en el servidor para añadir campos, pero el frontend aún procesaba el formato anterior. Asimismo, desconexiones breves en el bus 1-Wire inyectaban valores nulos que interrumpían la gráfica.

Solución Aplicada: Estandarización estricta del esquema JSON, corrección del mapeo en Astro y filtrado de lecturas espurias de bus abierto (como −127,0

◦C o +85,0

◦C).

## 6 Conclusiones y Próximos Pasos Inmediatos

### 6.1 Conclusiones del Desarrollo Individual

El desarrollo del fotobiorreactor automatizado ALUNA PBR-02 ha permitido demostrar que es factible diseñar, simular y construir un sistema de control de temperatura de grado científico para biotecnología marina con un presupuesto inferior a los $400.000 COP (aproximadamente $100 USD), frente a alternativas comerciales que superan los $15’000.000 COP.
En el plano individual, los hitos consolidados bajo mi liderazgo técnico fueron:
1. Validación Teórica Integral en MATLAB/Simulink: Se formuló e implementó exitosamente el modelo continuo de 4 EDOs no lineales (Droop + balance térmico Peltier). La generación procedural del modelo aluna_pbr_simulink.slx demostró que el mecanismo biomimético del Frailejón reduce el consumo eléctrico activo de la celda Peltier en más de un 40 %.
2. Arquitectura Embebida de Alta Eficiencia: El firmware programado en C++ para la ESP32 opera de forma totalmente asíncrona y no bloqueante, sincronizando dos sondas 1-Wire a 10 bits de resolución, un timer PWM por hardware a 1 kHz y la cinemática de un servomotor MG996R sin pérdida de muestras ni retardos acumulativos.
3. Ecosistema IoT Operativo en Tiempo Real: Se logró el despliegue exitoso del backend en Python (Flask) y el Dashboard web reactivo en Astro con visualizaciones de Apache ECharts, permitiendo supervisar el biorreactor, inspeccionar el gradiente térmico y operar actuadores de forma local y remota a 115200 baud.
4. Superación Experimental de Retos Físicos: Se diagnosticaron y corrigieron exitosamente anomalías termodinámicas y eléctricas reales (inversión de polaridad Peltier, cuello de botella conductivo del PET y caídas de tensión por resistencia parásita), consolidando un banco de pruebas físicamente estable.

### 6.2 Próximos Pasos Inmediatos (Plan de Trabajo)

Para culminar la transición del prototipo hacia su fase biológica activa, se ha establecido la siguiente hoja de ruta de ingeniería y validación experimental:
Hito 1: Finalización del Mecanismo de Apertura del Escudo Frailejón: Culminar el acoplamiento cinemático entre el piñón metálico del servomotor MG996R y la pantalla semicilíndrica reflectiva de tela blanca (0
- → 180◦
) para automatizar el
blindaje diurno frente a la sobre-irradiancia solar.
Hito 2: Mejora y Blindaje Térmico del Sistema Físico: Instalar una camisa exterior de aislamiento térmico de espuma elastomérica sobre las caras de la botella PET que no están en contacto con la celda, y optimizar el puente térmico con pasta disipadora de alta conductividad (> 5,0W/(m · K)).
Hito 3: Caracterización FOPDT y Sintonía Definitiva Cohen-Coon: Ejecutar una prueba ininterrumpida de respuesta al escalón en lazo abierto (0 → 100 % PWM)

sobre el volumen real de agua para extraer experimentalmente los parámetros de ganancia K, constante de tiempo τ y retardo de transporte L, cargando los coeficientes sintonizados en el lazo digital de la ESP32.
Hito 4: Inoculación de la Cepa Viva (Tetraselmis chuii): Introducir el inóculo celular en medio estéril Guillard f/2 con aireación constante e iniciar la prueba biológica de 72 horas bajo fotoperiodo controlado (12h luz / 12h oscuridad) para evaluar la tasa de crecimiento celular y estabilidad osmótica a 21,0

◦C.
