DevManyPB/Control-2/(commit log)

2026-09-13 feat(aluna): integracion control termico Tetraselmis chuii, servo MG996R escudo orbital, firmware ESP32, backend Flask, dashboard Astro y manual LaTeX para Overleaf
2026-09-13 fix(latex): resolver conflicto de babel spanish con tikz agregando es-noquoting y libreria babel
2026-09-13 feat(ui): sustitucion completa de Plotly por Apache ECharts, medidores radiales HUD estilo Tesla y gemelo digital vectorizado
2026-09-13 feat(ui): autoconexion inteligente de ESP32, boton unico de desconexion y guia de operacion interactiva integrada
2026-09-13 fix(ui): correccion robusta de apertura y cierre del modal de guia de operacion
2026-09-13 feat(iot): agregar Web IDE compilador ESP32 y banco de diagnostico de sensores independientes
2026-09-13 fix(frontend): corregir camelCase yAxis en ECharts para evitar excepción y restaurar navegación y autoconexión
2026-09-13 fix(iot): parsear telemetria en tiempo real tanto CSV como diagnostico test_sensores y mostrar -127C en frontend
    [app.py]
2026-09-13 fix(sensores): firmware de test dual optimizado a 10 bits con extraccion csv y lectura real a 34C en D15
    [app.py, esp32_firmware.ino, scanner_sensores.ino, test_sensores.ino, verificar_ds18b20.ino]
2026-09-13 feat: firmware monocanal oficial cargado al ESP32 con soporte de ensayo FOPDT
2026-09-13 feat(esp32): firmware híbrido oficial DS18B20 + DHT22 cargado en ESP32 con telemetría de 6 canales
2026-09-14 fix(hardware): update DS18B20 water sensor pin to D14 with auto-scanner and verified live telemetry
    [app.py, esp32_firmware.ino, step_response.ino, test_sensores.ino]
2026-09-14 fix(hardware): restore D15 (water) and D13 (ambient) configuration with confirmed live readings
    [esp32_firmware.ino, step_response.ino, test_sensores.ino]
2026-09-14 fix(control): enable hardware output driver for D25 Peltier PWM and add instant UI feedback on start
    [app.py, esp32_firmware.ino]
2026-09-14 fix(frontend): reparar renderizado de graficas ECharts y autoescala termica
2026-09-22 Sync desde JHON-IDEAPAD-SLIM-3-14ARP10 — 2026-09-22 14:53
    Synced-From: JHON-IDEAPAD-SLIM-3-14ARP10
